reilleya/CF-Chef/hardware/controller/components/TPS2121RUXR/TPS2121RUXR.step

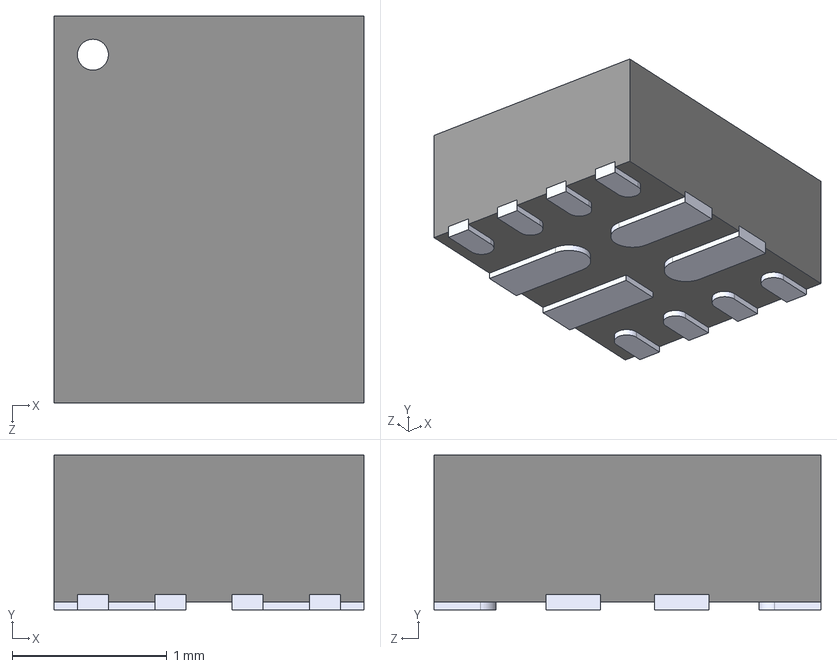
[picture p1: CAD file, 2026-02-15]
hardware/controller/components/TPS2121RUXR/TPS2121RUXR.step
2.00 x 1.00 x 2.50 mm
