reilleya/CF-Chef/hardware/controller/controller.kicad_pcb

## KiCad design hardware/controller/controller.kicad_pcb (2026-07-04)

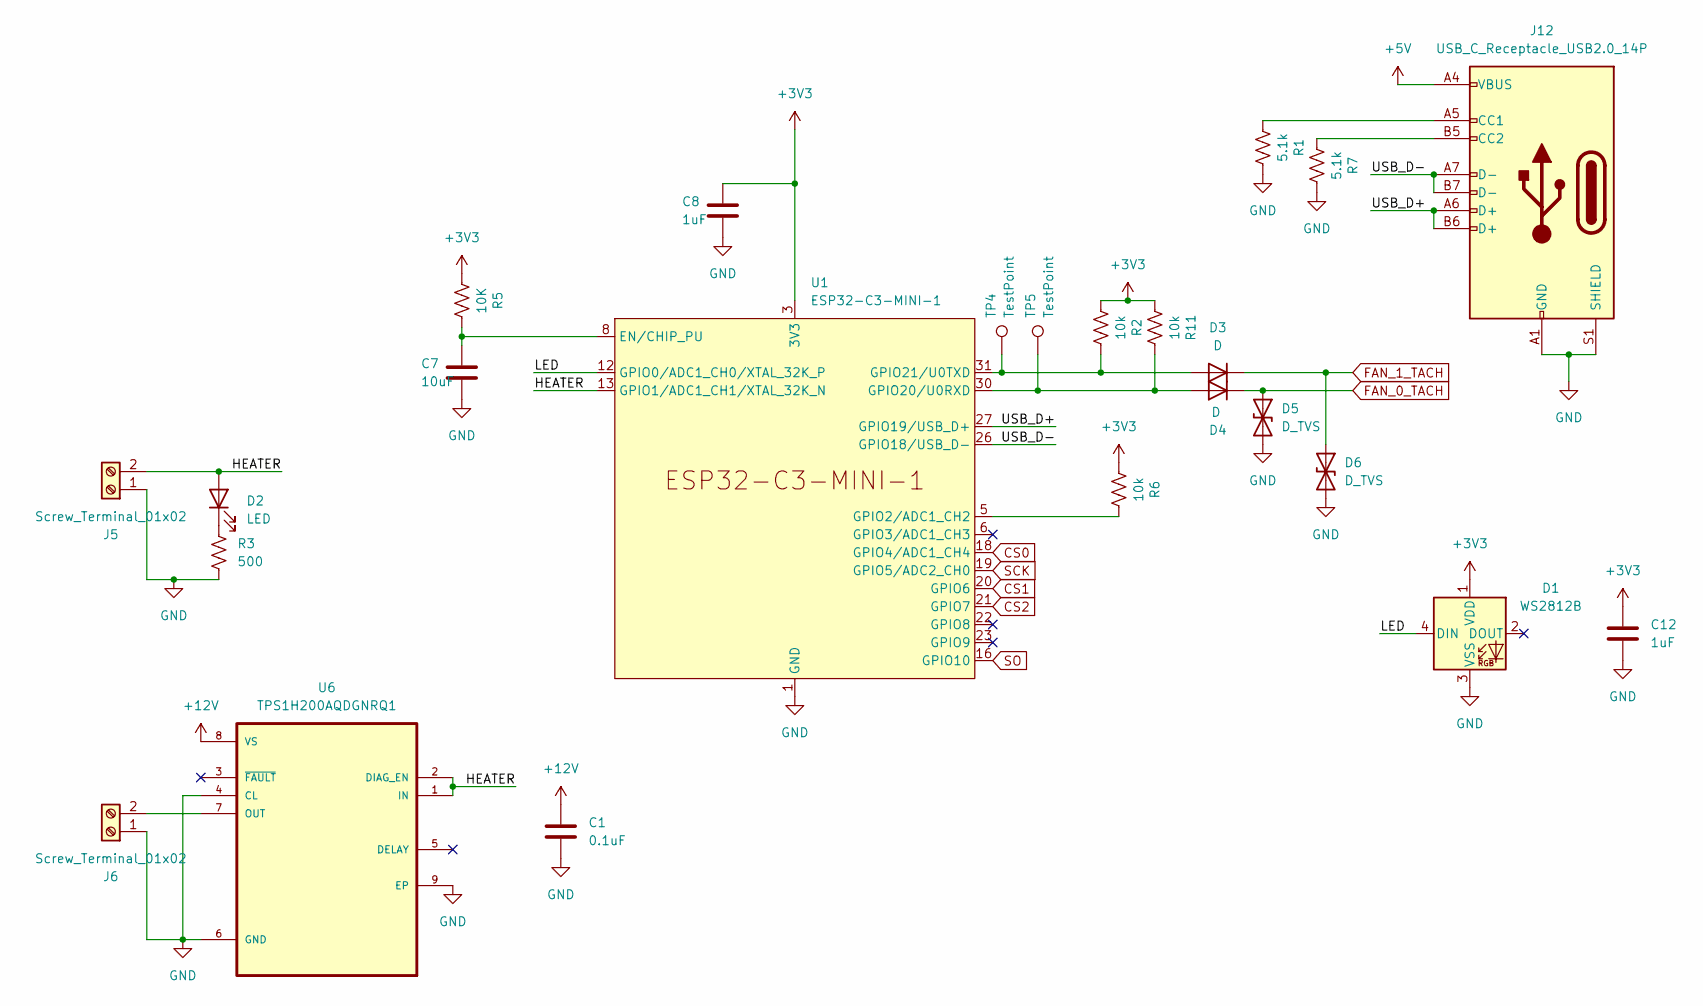
[picture p2: schematic mcu.kicad_sch]

Parts:
C1: 0.1uF; C_0805_2012Metric; LCSC C49678
C7: 10uF; C_0805_2012Metric; LCSC` C15850
C8, C12: 1uF; C_0805_2012Metric; LCSC C28323
D1: WS2812B; LED_WS2812B_PLCC4_5.0x5.0mm_P3.2mm; LCSC C2874885
D2: LED; LED_0805_2012Metric; LCSC C84256
D3, D4: D; TSOT-23; LCSC C14308
D5, D6: D_TVS; D_SOD-323F; LCSC C502541
J5, J6: Screw_Terminal_01x02; TerminalBlock_4Ucon_1x02_P3.50mm_Horizontal
J12: USB_C_Receptacle_USB2.0_14P; USB_C_Receptacle_GCT_USB4105-xx-A_16P_TopMnt_Horizontal; LCSC C2765186
R1, R7: 5.1k; R_0805_2012Metric; LCSC C27834
R2, R6, R11: 10k; R_0805_2012Metric; LCSC C84376
R3: 500; R_0805_2012Metric; LCSC C2828857
R5: 10K; R_0805_2012Metric; LCSC C84376
TP4, TP5: TestPoint; TestPoint_THTPad_2.0x2.0mm_Drill1.0mm
U1: ESP32-C3-MINI-1; LCSC C2838502
U6: TPS1H200AQDGNRQ1; SOP65P490X110-9N; LCSC C2653785

Connections:
+3V3: C8.1, C12.1, D1.1 (VDD), R2.2, R5.2, R6.2, R11.2, U1.3 (3V3); also elsewhere on the board
+5V: J12.A4 (VBUS), J12.A9 (VBUS), J12.B4 (VBUS), J12.B9 (VBUS); also elsewhere on the board
+12V: C1.1, U6.8 (VS); also elsewhere on the board
/Microcontroller/HEATER: D2.2 (A), J5.2, U1.13 (GPIO1/ADC1_CH1/XTAL_32K_N), U6.1 (IN), U6.2 (DIAG_EN)
/Microcontroller/LED: D1.4 (DIN), U1.12 (GPIO0/ADC1_CH0/XTAL_32K_P)
/Microcontroller/USB_D+: J12.A6 (D+), J12.B6 (D+), U1.27 (GPIO19/USB_D+)
/Microcontroller/USB_D-: J12.A7 (D-), J12.B7 (D-), U1.26 (GPIO18/USB_D-)
CS0: U1.18 (GPIO4/ADC1_CH4); also elsewhere on the board
CS1: U1.20 (GPIO6); also elsewhere on the board
CS2: U1.21 (GPIO7); also elsewhere on the board
FAN_0_TACH: D4.3 (K), D5.1 (A1); also elsewhere on the board
FAN_1_TACH: D3.3 (K), D6.1 (A1); also elsewhere on the board
GND: C1.2, C7.2, C8.2, C12.2, D1.3 (VSS), D5.2 (A2), D6.2 (A2), J5.1, J6.1, J12.A1 (GND), J12.A12 (GND), J12.B1 (GND), J12.B12 (GND), J12.S1 (SHIELD), R1.1, R3.2, R7.1, U1.1 (GND), U1.2 (GND), U1.11 (GND), U1.14 (GND), U1.36 (GND), U1.37 (GND), U1.38 (GND), U1.39 (GND), U1.40 (GND), U1.41 (GND), U1.42 (GND), U1.43 (GND), U1.44 (GND), U1.45 (GND), U1.46 (GND), U1.47 (GND), U1.48 (GND), U1.49 (GND), U1.50 (GND), U1.51 (GND), U1.52 (GND), U1.53 (GND), U6.4 (CL), U6.6 (GND), U6.9 (EP); also elsewhere on the board
unnamed: D2.1 (K), R3.1
unnamed: D3.1 (A), R2.1, TP4.1, U1.31 (GPIO21/U0TXD)
unnamed: D4.1 (A), R11.1, TP5.1, U1.30 (GPIO20/U0RXD)
unnamed: J6.2, U6.7 (OUT)
unnamed: J12.A5 (CC1), R1.2
unnamed: J12.B5 (CC2), R7.2
unnamed: C7.1, R5.1, U1.8 (EN/CHIP_PU)
unnamed: R6.1, U1.5 (GPIO2/ADC1_CH2)
SCK: U1.19 (GPIO5/ADC2_CH0); also elsewhere on the board
SO: U1.16 (GPIO10); also elsewhere on the board

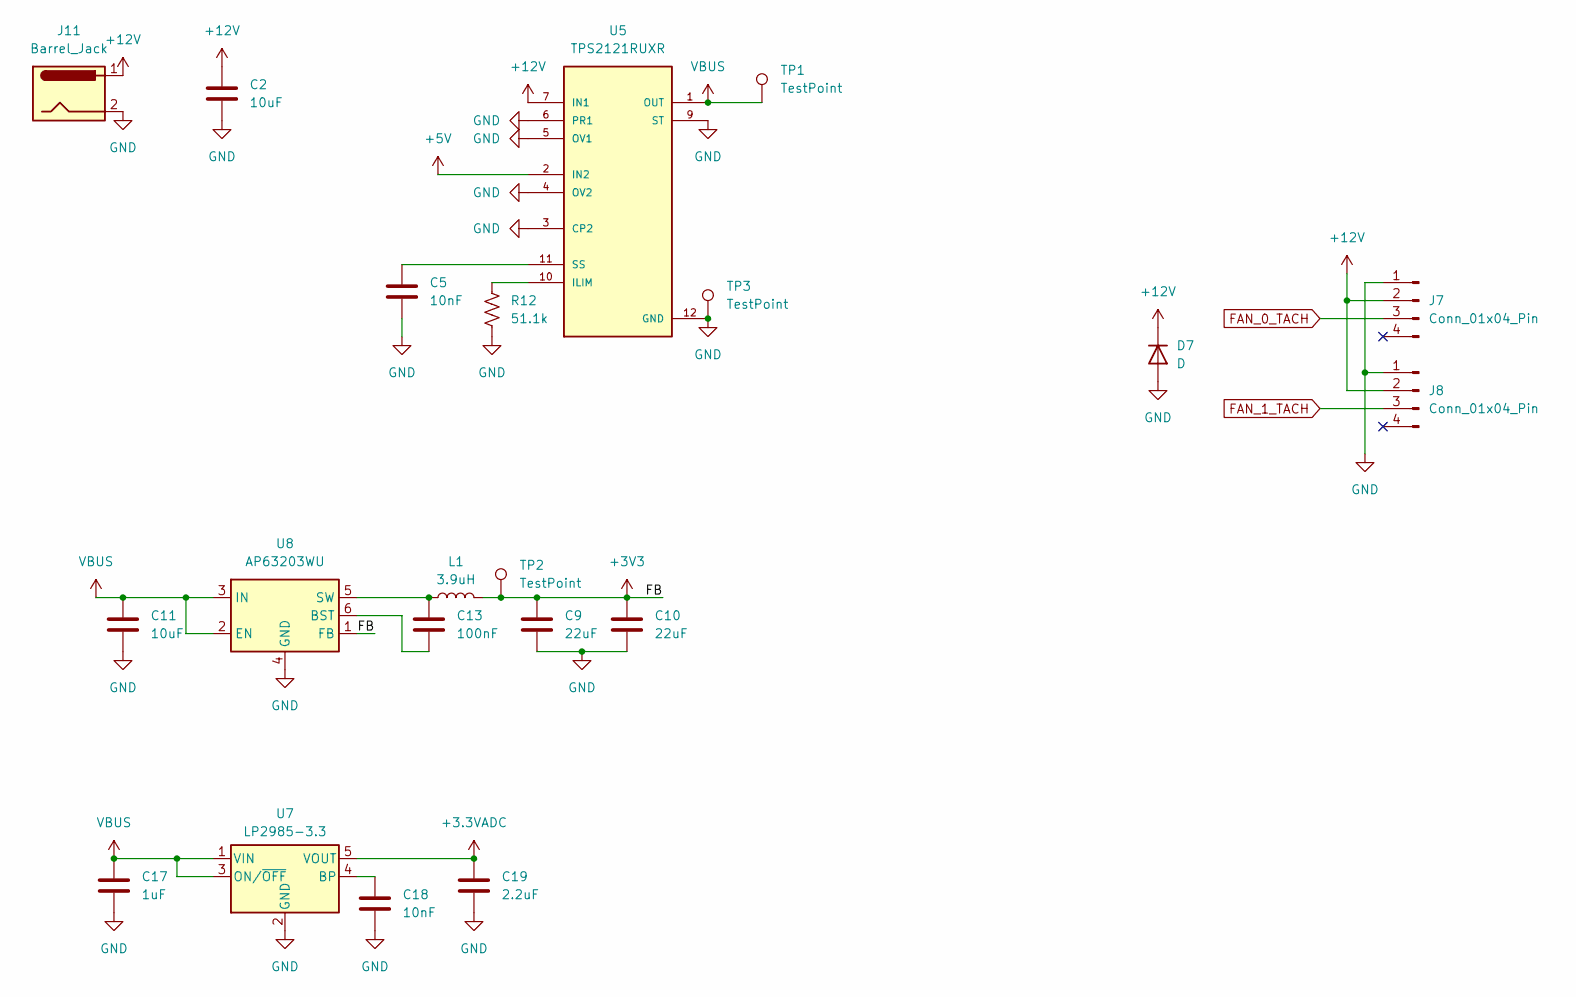
[picture p3: schematic power.kicad_sch]

Parts:
C2, C11: 10uF; C_0805_2012Metric; LCSC C15850
C5, C18: 10nF; C_0805_2012Metric; LCSC C1710
C9, C10: 22uF; C_0805_2012Metric; LCSC C5674
C13: 100nF; C_0805_2012Metric; LCSC C1711
C17: 1uF; C_0805_2012Metric; LCSC C28323
C19: 2.2uF; C_0805_2012Metric; LCSC C377773
D7: D; D_SMA; LCSC C445494
J7, J8: Conn_01x04_Pin; FanPinHeader_1x04_P2.54mm_Vertical
J11: Barrel_Jack; BarrelJack_CUI_PJ-063AH_Horizontal
L1: 3.9uH; L_APV_ANR3015; LCSC C42429305
R12: 51.1k; R_0805_2012Metric; LCSC C17731
TP1, TP2, TP3: TestPoint; TestPoint_THTPad_2.0x2.0mm_Drill1.0mm
U5: TPS2121RUXR; IC_TPS2121RUXR; LCSC C485916
U7: LP2985-3.3; SOT-23-5; LCSC C95414
U8: AP63203WU; TSOT-23-6; LCSC C780769

Connections:
+3.3VADC: C19.1, U7.5 (VOUT); also elsewhere on the board
+3V3: C9.1, C10.1, L1.2, TP2.1, U8.1 (FB); also elsewhere on the board
+5V: U5.2 (IN2), U5.2_1 (IN2); also elsewhere on the board
+12V: C2.1, D7.1 (K), J7.2, J8.2, J11.1, U5.7 (IN1), U5.7_1 (IN1); also elsewhere on the board
FAN_0_TACH: J7.3; also elsewhere on the board
FAN_1_TACH: J8.3; also elsewhere on the board
GND: C2.2, C5.2, C9.2, C10.2, C11.2, C17.2, C18.2, C19.2, D7.2 (A), J7.1, J8.1, J11.2, R12.2, TP3.1, U5.3 (CP2), U5.4 (OV2), U5.5 (OV1), U5.6 (PR1), U5.9 (ST), U5.12 (GND), U7.2 (GND), U8.4 (GND); also elsewhere on the board
unnamed: R12.1, U5.10 (ILIM)
unnamed: C5.1, U5.11 (SS)
unnamed: C18.1, U7.4 (BP)
unnamed: C13.2, U8.6 (BST)
unnamed: C13.1, L1.1, U8.5 (SW)
VBUS: C11.1, C17.1, TP1.1, U5.1 (OUT), U5.1_1 (OUT), U5.8 (OUT), U5.8_1 (OUT), U7.1 (VIN), U7.3 (ON/~OFF), U8.2 (EN), U8.3 (IN)

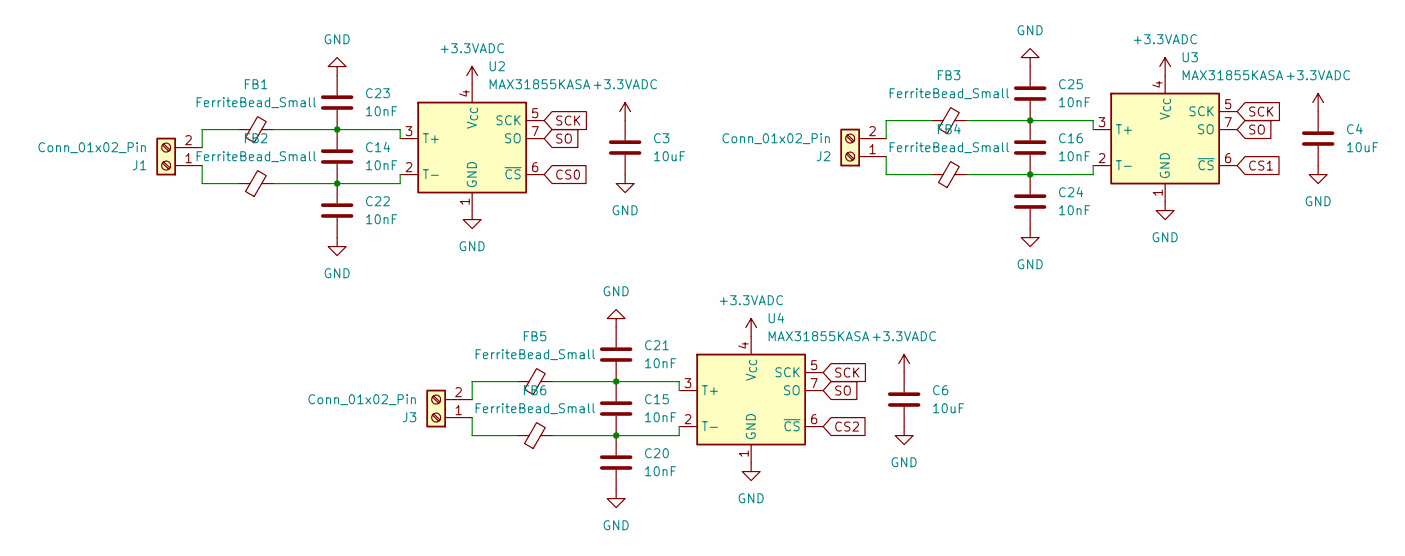
[picture p4: schematic thermocouples.kicad_sch]

Parts:
C3, C4, C6: 10uF; C_0805_2012Metric; LCSC C15850
C14, C15, C16, C20, C21, C22, C23, C24, C25: 10nF; C_0805_2012Metric; LCSC C1710
FB1, FB2, FB3, FB4, FB5, FB6: FerriteBead_Small; C_0805_2012Metric; LCSC C397304
J1, J2, J3: Conn_01x02_Pin; TerminalBlock_4Ucon_1x02_P3.50mm_Horizontal
U2, U3, U4: MAX31855KASA; SOIC-8_3.9x4.9mm_P1.27mm; LCSC C52028

Connections:
+3.3VADC: C3.1, C4.1, C6.1, U2.4 (V_{CC}), U3.4 (V_{CC}), U4.4 (V_{CC}); also elsewhere on the board
CS0: U2.6 (~CS); also elsewhere on the board
CS1: U3.6 (~CS); also elsewhere on the board
CS2: U4.6 (~CS); also elsewhere on the board
GND: C3.2, C4.2, C6.2, C20.2, C21.1, C22.2, C23.1, C24.2, C25.1, U2.1 (GND), U3.1 (GND), U4.1 (GND); also elsewhere on the board
unnamed: FB2.1, J1.1
unnamed: FB1.1, J1.2
unnamed: FB4.1, J2.1
unnamed: FB3.1, J2.2
unnamed: FB6.1, J3.1
unnamed: FB5.1, J3.2
unnamed: C14.1, C23.2, FB1.2, U2.3 (T+)
unnamed: C14.2, C22.1, FB2.2, U2.2 (T-)
unnamed: C16.1, C25.2, FB3.2, U3.3 (T+)
unnamed: C16.2, C24.1, FB4.2, U3.2 (T-)
unnamed: C15.1, C21.2, FB5.2, U4.3 (T+)
unnamed: C15.2, C20.1, FB6.2, U4.2 (T-)
SCK: U2.5 (SCK), U3.5 (SCK), U4.5 (SCK); also elsewhere on the board
SO: U2.7 (SO), U3.7 (SO), U4.7 (SO); also elsewhere on the board

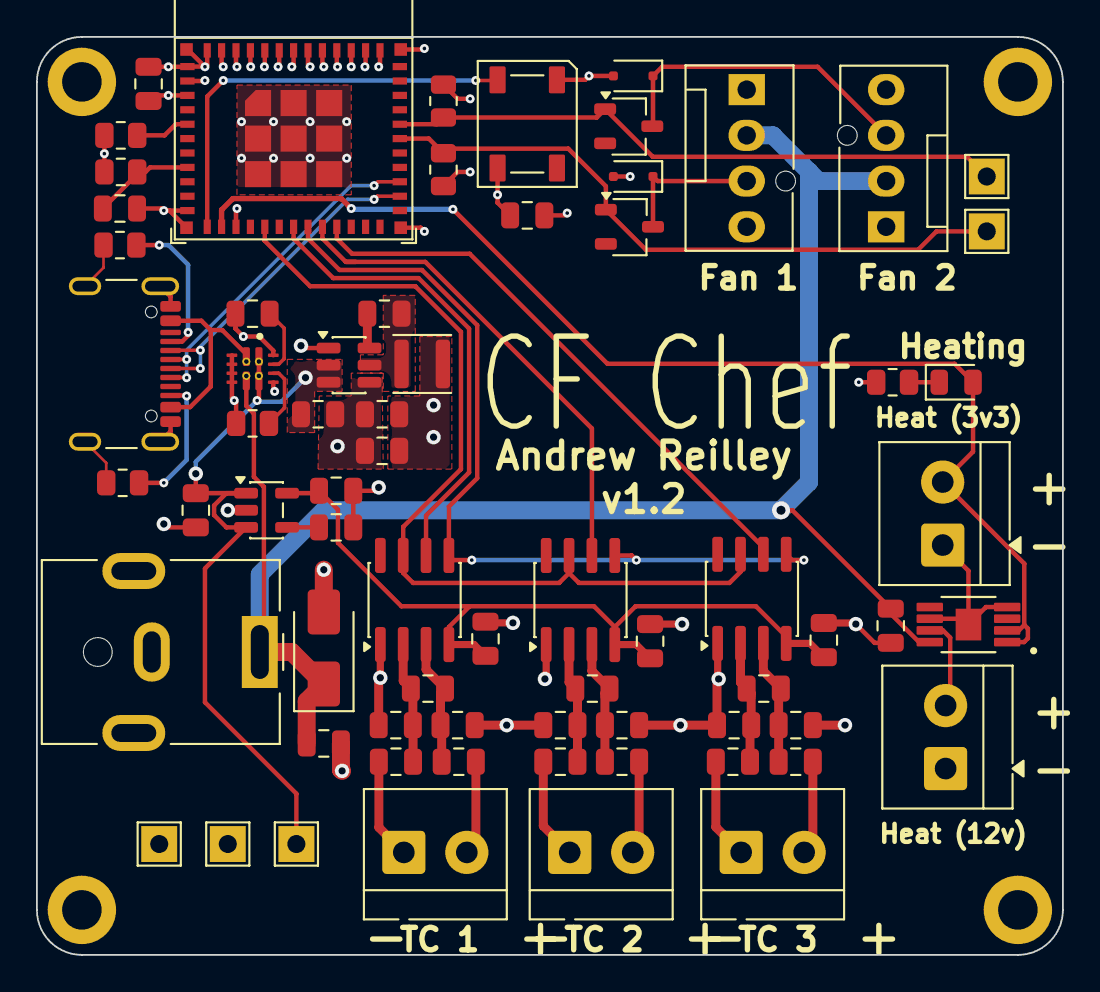
[picture p5: board controller.kicad_pcb from above]

Board: 4 copper layers, 57.0 x 51.0 mm, 73 parts (0 on the bottom side), 42 nets.

Other parts of the board:
H1, H2, H3, H4: MountingHole; MountingHole_2.2mm_M2_ISO14580_Pad
