reilleya/CF-Chef/(commit log)

2026-01-19 Bring up LED
2026-02-08 Pre-state-machine prototype of simple oven run
2026-02-11 Read zone temperatures in a loop, include in state object
2026-02-15 Replace input diodes with power mux chip
    [TPS2121RUXR.step, controller.kicad_pcb, power.kicad_sch]
2026-02-15 Swap out voltage regulator
    [controller.kicad_pcb, power.kicad_sch]
2026-02-15 Widen board and add polarity labels to heater outputs
    [controller.kicad_pcb, mcu.kicad_sch]
2026-02-23 Move 12v out from under TC chips
    [controller.kicad_pcb]
2026-02-24 Update inductor to match regulator spec better
    [controller.kicad_pcb, power.kicad_sch]
2026-03-07 1.1 production tweaks
    [controller.kicad_pcb, power.kicad_sch]
2026-03-08 Protect fan tach inputs
    [controller.kicad_pcb, mcu.kicad_sch, power.kicad_sch]
2026-03-08 Add TVS diode to 12V rail
    [controller.kicad_pcb, power.kicad_sch]
2026-03-18 Reroute regulator
    [controller.kicad_pcb]
2026-03-19 Increase via size for manufacturing
    [controller.kicad_pcb, mcu.kicad_sch, power.kicad_sch]
2026-03-20 Fix power mux rotation
    [controller.kicad_pcb, power.kicad_sch]
2026-03-30 Fix diode footprints
    [controller.kicad_pcb, mcu.kicad_sch]
2026-04-01 Reset LED color immediately on startup
    [main.rs]
2026-04-04 Read fan speed and include it in status
2026-04-04 Monitor for fan faults and include in status
2026-04-09 Switch from form submission to json
2026-05-08 Add prototype of system status box
2026-05-13 Add filtering caps to thermocouples
    [controller.kicad_pcb, thermocouples.kicad_sch]
2026-06-11 Add configurable temperature bounds
2026-06-23 Fix high SPI clock speed leading to occasional bad TC readings
    [main.rs]
2026-06-24 Add linear regulator for MAX chips
    [controller.kicad_pcb, power.kicad_sch, thermocouples.kicad_sch]
2026-06-25 Increase capacitance of MAX caps
    [controller.kicad_pcb, thermocouples.kicad_sch]
2026-07-03 Add ferrites and more caps to thermocouples
    [controller.kicad_pcb, thermocouples.kicad_sch]
2026-07-04 Move output terminals, resize board
    [controller.kicad_pcb, mcu.kicad_sch]
